kgieselman/Lily58/SMT_ASSY/kicad_library_keyboard/README.md

# kicad_library_keyboard
KiCAD library for Keyboard components
