kgieselman/Lily58/pcb/Keyboard_3DModels/Stabilizer - close.STEP

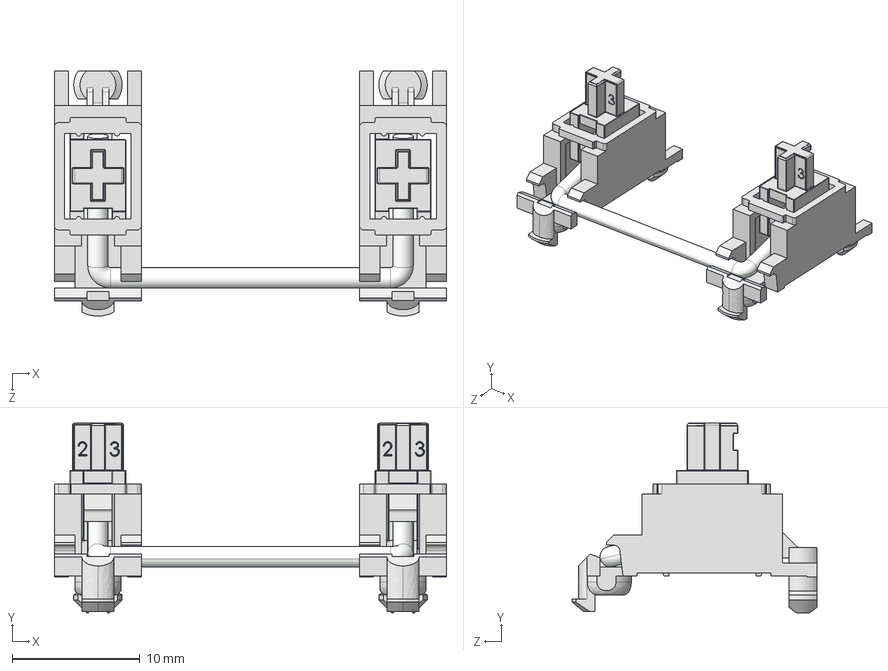
[picture p1: CAD file, 2020-09-15]
pcb/Keyboard_3DModels/Stabilizer - close.STEP
30.7 x 14.9 x 19.2 mm
mx Stabilizer base 16828 x 2
mx Stabilizer key 16828 x 2
metal stick 16828
