kgieselman/Lily58/pcb/Keyboard_3DModels/pec11r-4x15f-sxxxx.stp

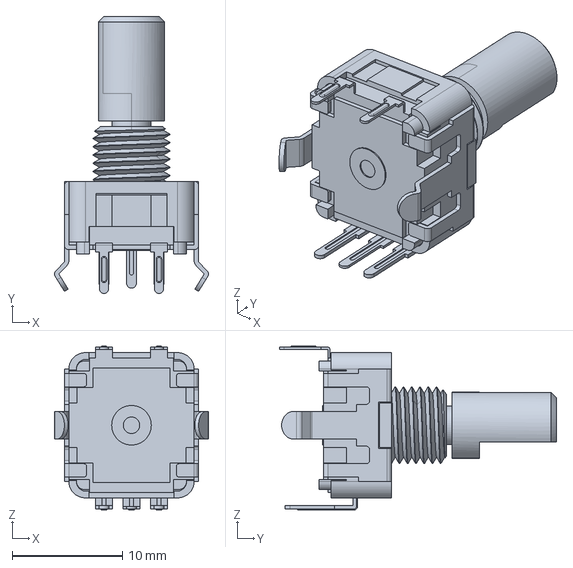
[picture p2: CAD file, 2020-09-15]
pcb/Keyboard_3DModels/pec11r-4x15f-sxxxx.stp
14.0 x 25.2 x 14.9 mm
