kgieselman/Lily58/pcb/Keyboard_3DModels/SPDT_SLIDE_SSSS213000.STEP

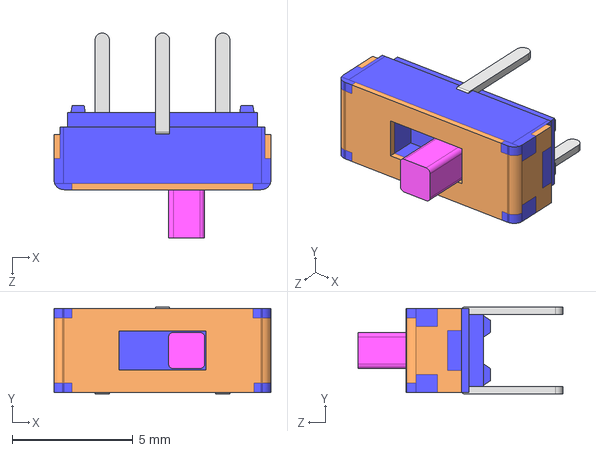
[picture p3: CAD file, 2020-09-01]
pcb/Keyboard_3DModels/SPDT_SLIDE_SSSS213000.STEP
9.00 x 3.60 x 8.50 mm
