kgieselman/Lily58/pcb/Keyboard_3DModels/HIROSE_USBC_CX90M-16P_4800513000_3D_STEP.stp

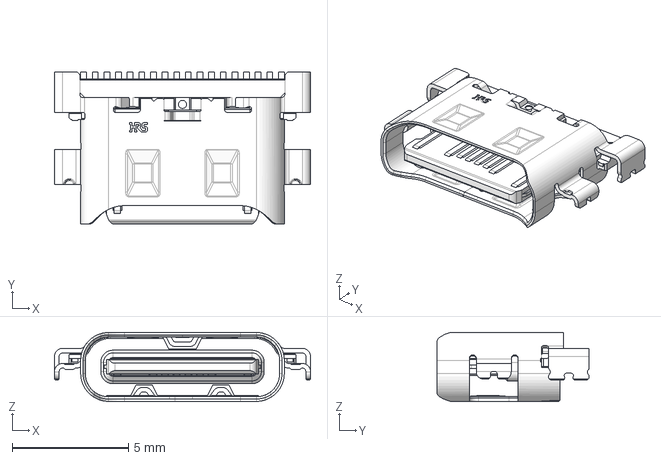
[picture p4: CAD file, 2020-09-01]
pcb/Keyboard_3DModels/HIROSE_USBC_CX90M-16P_4800513000_3D_STEP.stp
11.0 x 6.55 x 2.97 mm
