kgieselman/Lily58/pcb/Keyboard_3DModels/EC11E-15SW.STEP

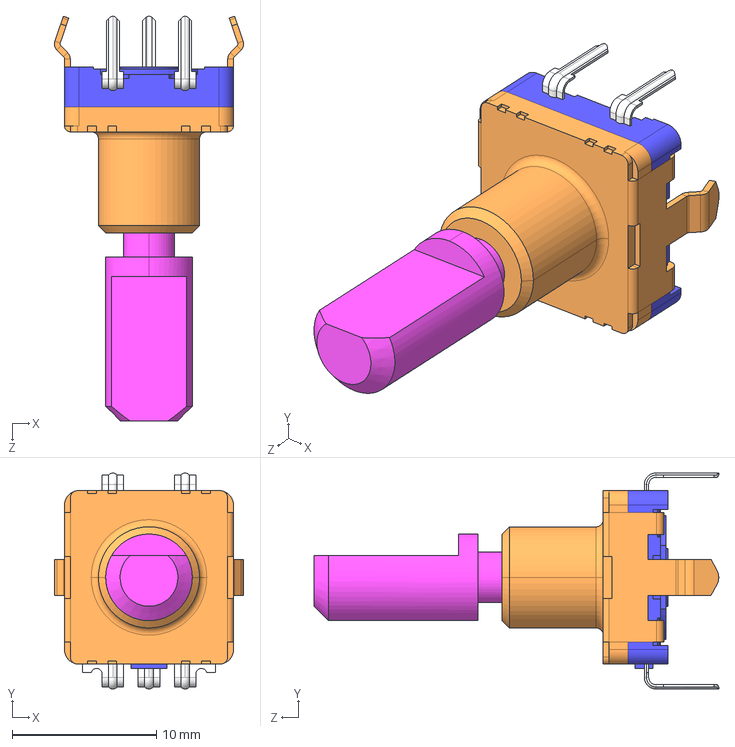
[picture p5: CAD file, 2020-09-01]
pcb/Keyboard_3DModels/EC11E-15SW.STEP
13.1 x 14.9 x 28.0 mm
