kgieselman/Lily58/pcb/Keyboard_3DModels/PTS636SM43SMTRLFS.stp

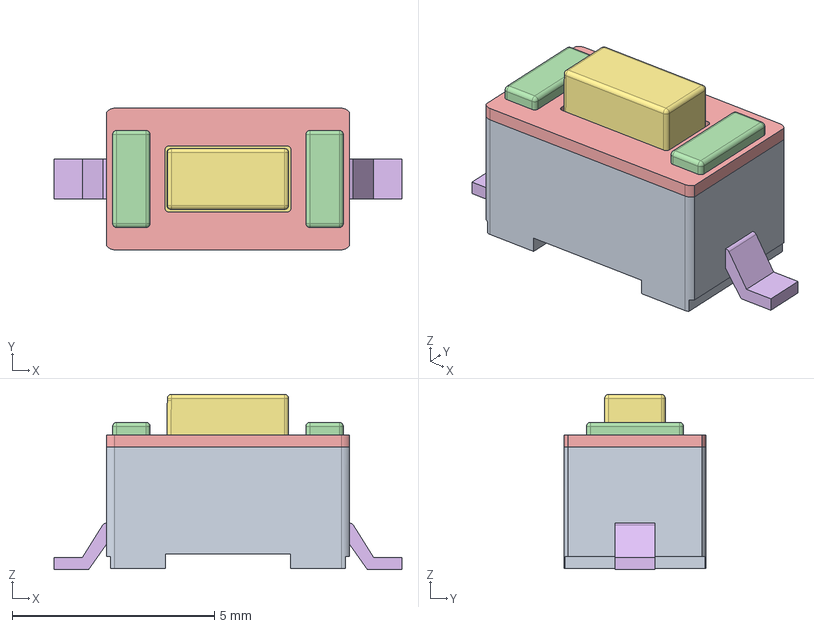
[picture p6: CAD file, 2020-09-01]
pcb/Keyboard_3DModels/PTS636SM43SMTRLFS.stp
8.60 x 3.50 x 4.33 mm
