kgieselman/Lily58/pcb/Keyboard_3DModels/USB_Micro_473460001.stp

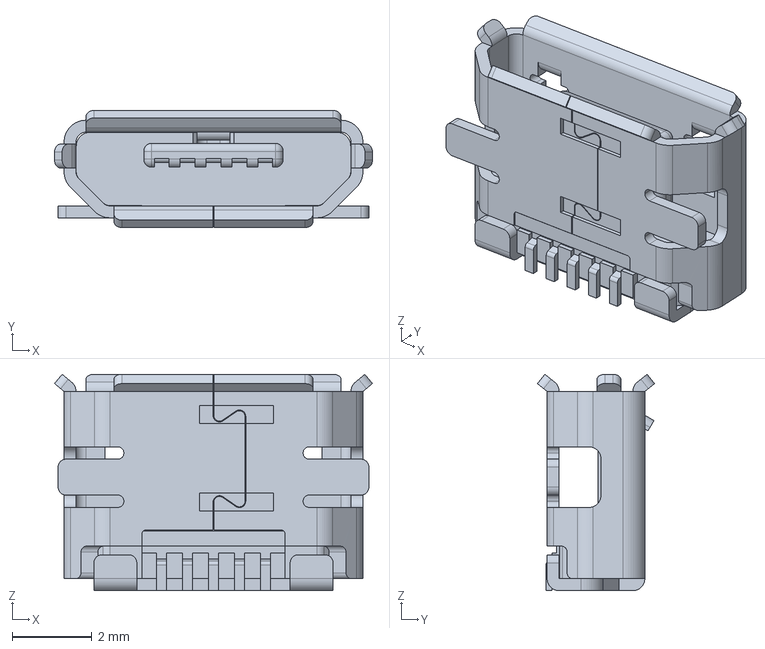
[picture p7: CAD file, 2020-09-01]
pcb/Keyboard_3DModels/USB_Micro_473460001.stp
7.98 x 2.94 x 5.43 mm
