kgieselman/Lily58/pcb/Keyboard_3DModels/RKJXT1F42001.STEP

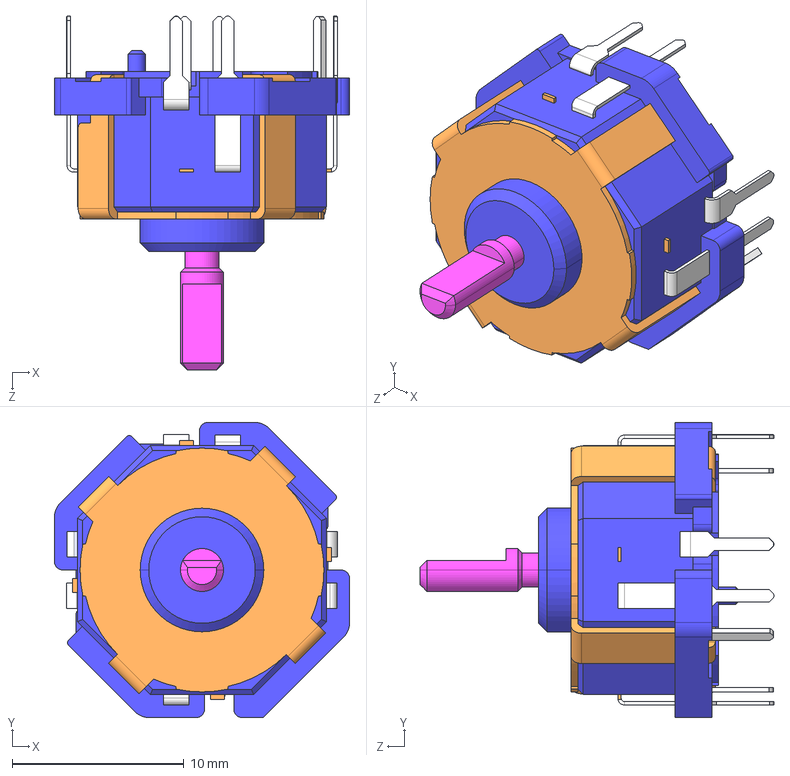
[picture p8: CAD file, 2020-09-01]
pcb/Keyboard_3DModels/RKJXT1F42001.STEP
17.2 x 17.2 x 20.6 mm
