kgieselman/Lily58/pcb/Keyboard_3DModels/PUSH_SW_SKHLAC.STEP

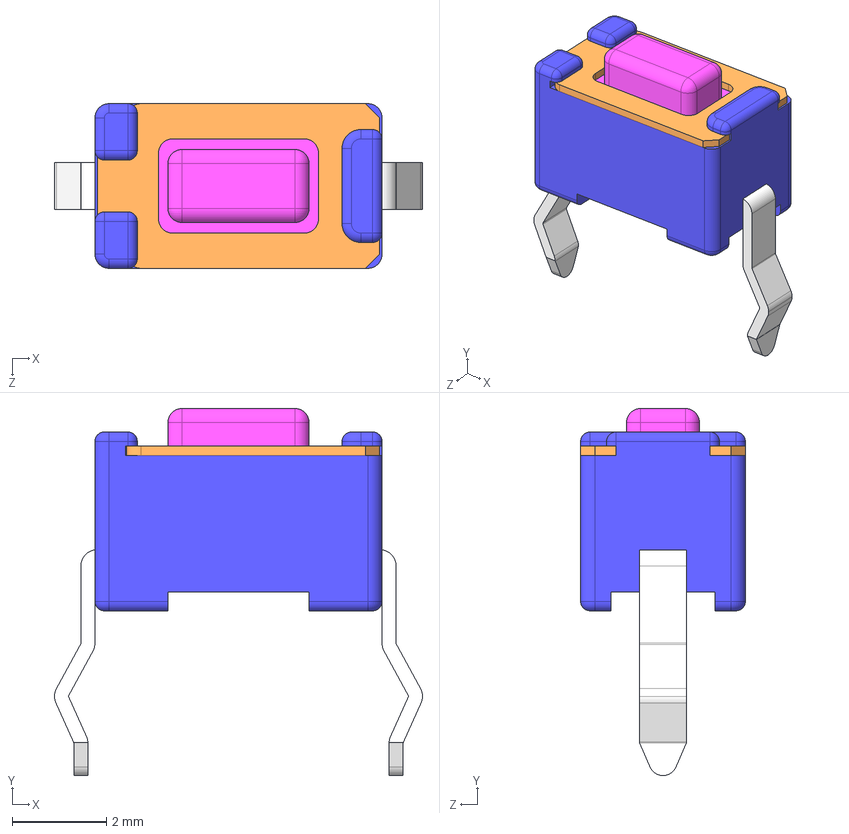
[picture p9: CAD file, 2020-09-01]
pcb/Keyboard_3DModels/PUSH_SW_SKHLAC.STEP
7.82 x 7.80 x 3.50 mm
