kgieselman/Lily58/pcb/Keyboard_3DModels/ABM3B.STEP

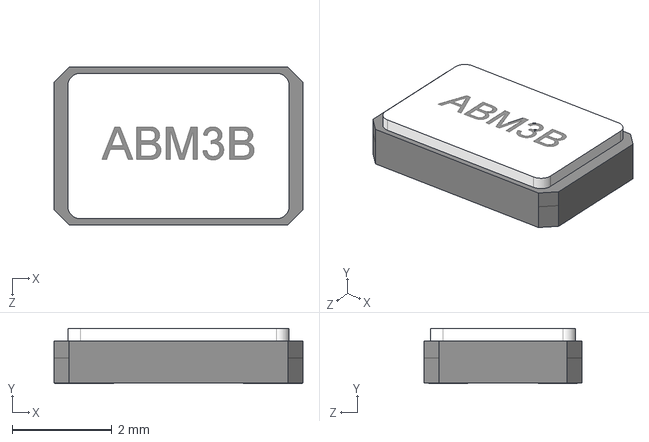
[picture p10: CAD file, 2020-09-01]
pcb/Keyboard_3DModels/ABM3B.STEP
5.00 x 1.11 x 3.18 mm
