kgieselman/Lily58/pcb/Keyboard_3DModels/FSM2JRT.stp

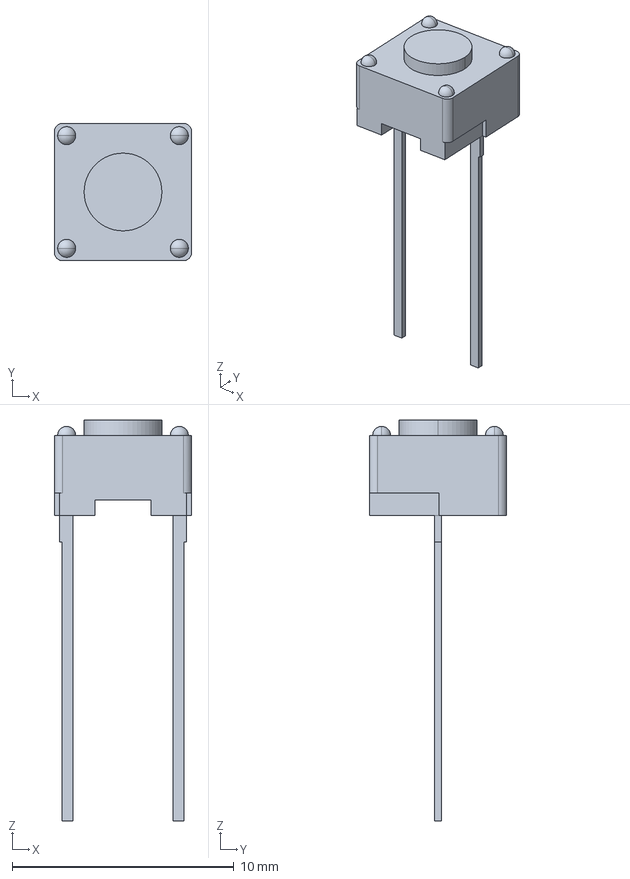
[picture p11: CAD file, 2020-09-01]
pcb/Keyboard_3DModels/FSM2JRT.stp
6.20 x 6.20 x 18.1 mm
