kgieselman/Lily58/pcb/Keyboard_3DModels/0.96 OLED v3.step

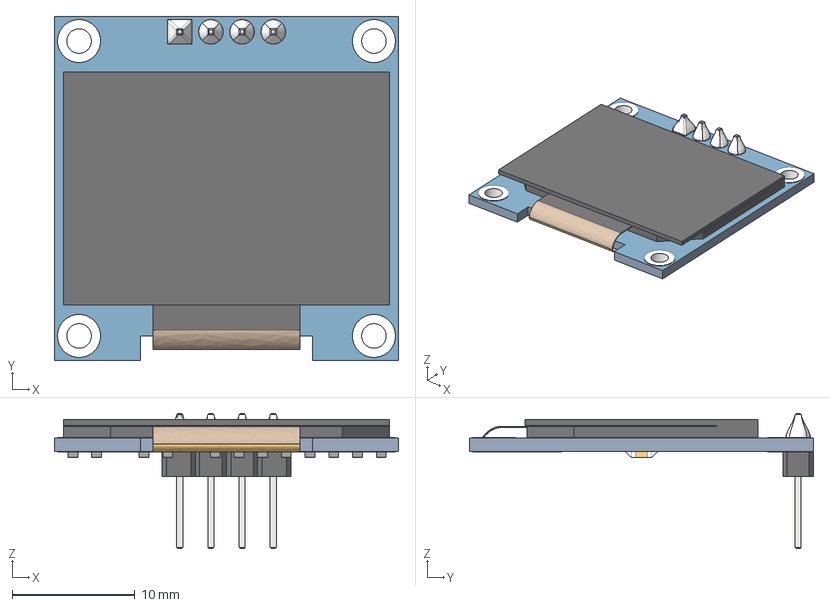
[picture p13: CAD file, 2020-09-01]
pcb/Keyboard_3DModels/0.96 OLED v3.step
28.0 x 28.0 x 11.0 mm
