kgieselman/Lily58/pcb/Keyboard_3DModels/USB_Micro_1050170001.stp

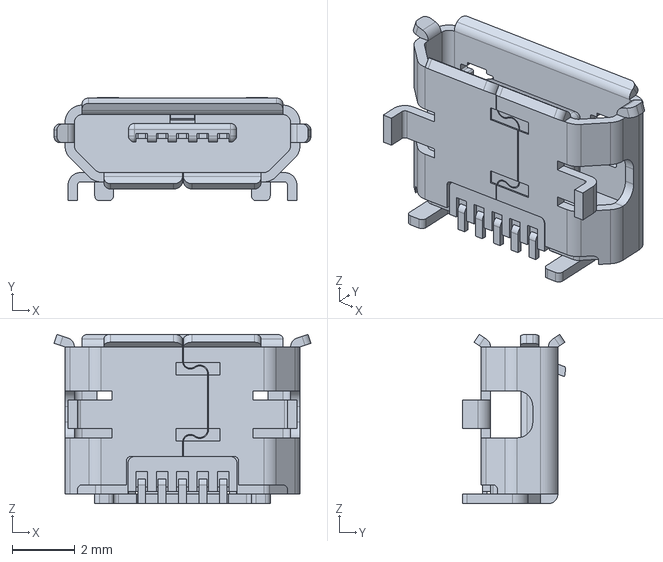
[picture p14: CAD file, 2020-09-01]
pcb/Keyboard_3DModels/USB_Micro_1050170001.stp
8.20 x 3.30 x 5.40 mm
