kgieselman/Lily58/pcb/Keyboard_3DModels/629105150521.stp

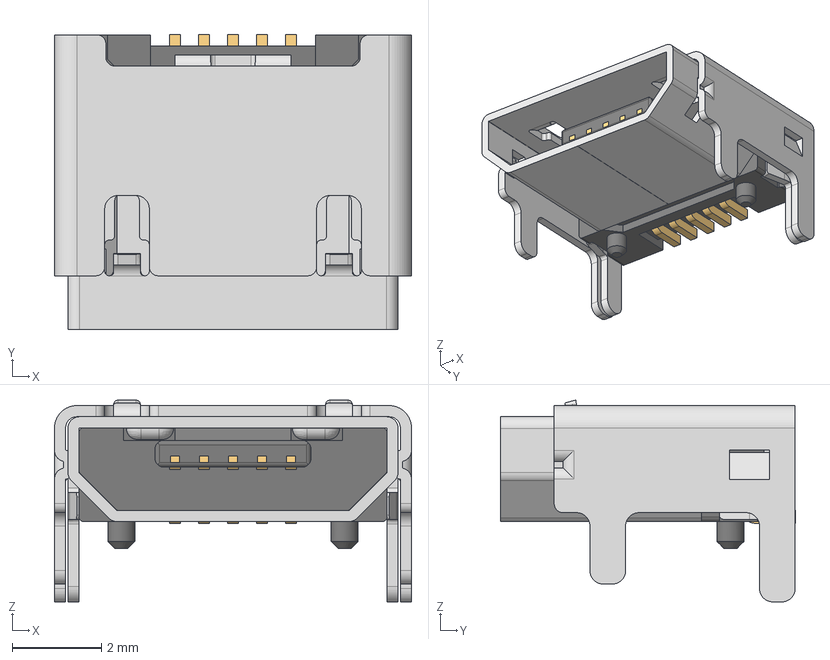
[picture p15: CAD file, 2020-09-15]
pcb/Keyboard_3DModels/629105150521.stp
8.00 x 6.60 x 4.52 mm
629105150521_Pin1 x 4
629105150521_Housing
629105150521_Pin2
629105150521_Shielding
629105150521_Shielding2
