kgieselman/Lily58/pcb/Keyboard_3DModels/OS102011MS2QN1.stp

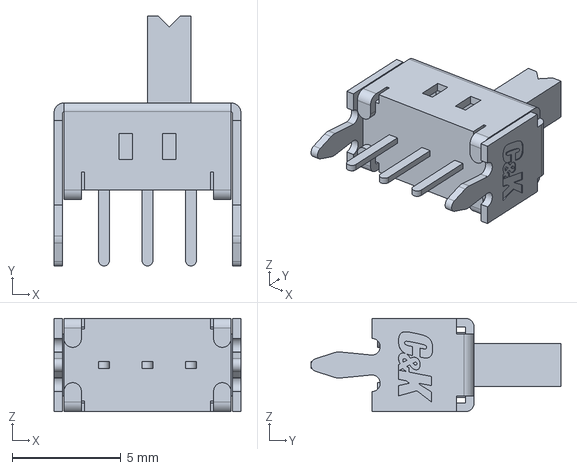
[picture p16: CAD file, 2020-09-01]
pcb/Keyboard_3DModels/OS102011MS2QN1.stp
8.60 x 11.5 x 4.30 mm
