kgieselman/Lily58/(commit log)

2020-09-01 Creating new version with lite as a foundation
    [0.96 OLED v3.step, ABM3B.STEP, EC11E-15SW.STEP, FSM2JRT.stp, HIROSE_USBC_CX90M-16P_4800513000_3D_STEP.stp, Lily58.kicad_pcb, Lily58.sch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]
2020-09-01 Updated to use my lib (mostly)
    [Lily58.sch]
2020-09-02 Updated layout to use more comps
    Need to do ATMEGA32U4 circuitry still
    [Lily58.kicad_pcb, Lily58.sch]
2020-09-02 Updated ATMEGA32U4 schematic
    [Lily58.sch]
2020-09-15 Start of update to use my library and re-route
    [0.96 OLED v3.step, 629105150521.stp, ABM3B.STEP, EC11E-15SW.STEP, FSM2JRT.stp, HIROSE_USBC_CX90M-16P_4800513000_3D_STEP.stp, Lily58.kicad_pcb, Lily58.sch]
2020-09-17 Update comps
    [Lily58.kicad_pcb, Lily58.sch]
