kgieselman/Lily58/(notices)

Notices in the files:
pcb/Keyboard_3DModels/PTS636SM43SMTRLFS.stp:
FILE_NAME( 'p:/temp/worker_546/temp/exporttempdir_2180_2_PNFBa/format_0/PTS636SM43SMTRLFS.stp', '2020-04-25T22:01:29', ( 'License CC BY-ND 4.0' ), ( 'CADENAS' ), ' ', 'PARTsolutions', ' ' );
